BrnoMarsRover/myMachine-Fan/README.md

# myMachine-Fan
Repository for my Machine Walking FAN project, including software, PCBs, and documentation.

Link to documentation page (in Czech): [Documentation](https://brnomarsrover.github.io/myMachine-Fan/)
