BrnoMarsRover/myMachine-Fan/docs/hardware/hw.md

## Podvozek
Podvozek je třeba správně propojit s ostatním komponenty, viz schéma.
Konektory jednotlivých komponent jsou již připraveny a pro účely propojení s řídícím mikrokontrolerem jsou v podvozku dva univerzální plošné spoje.

Pohled zvrchu:
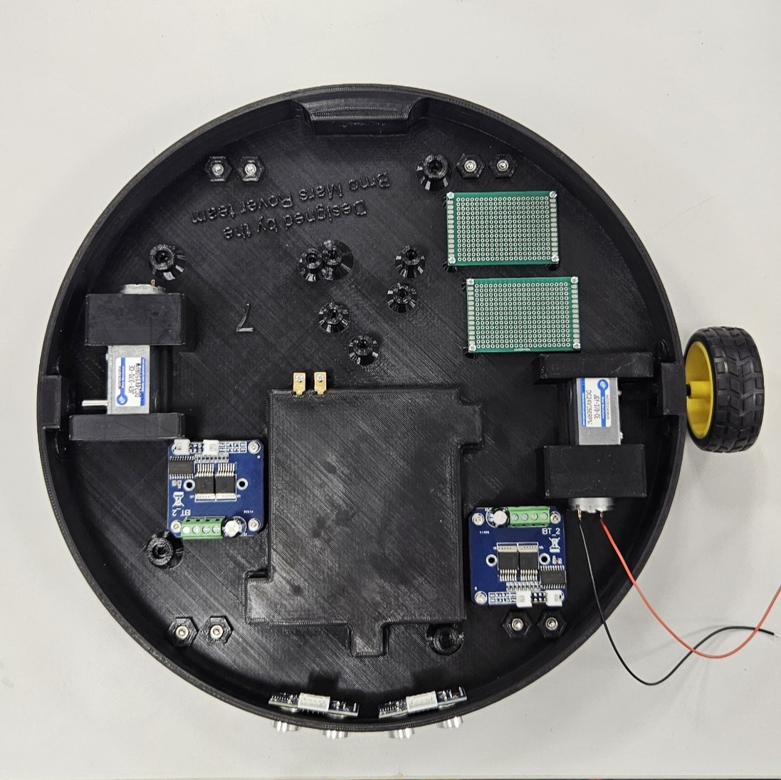
[picture p1: docs/images/hw/podvozek_top.jpg]
Podvozek_Top

Pohled zespodu:
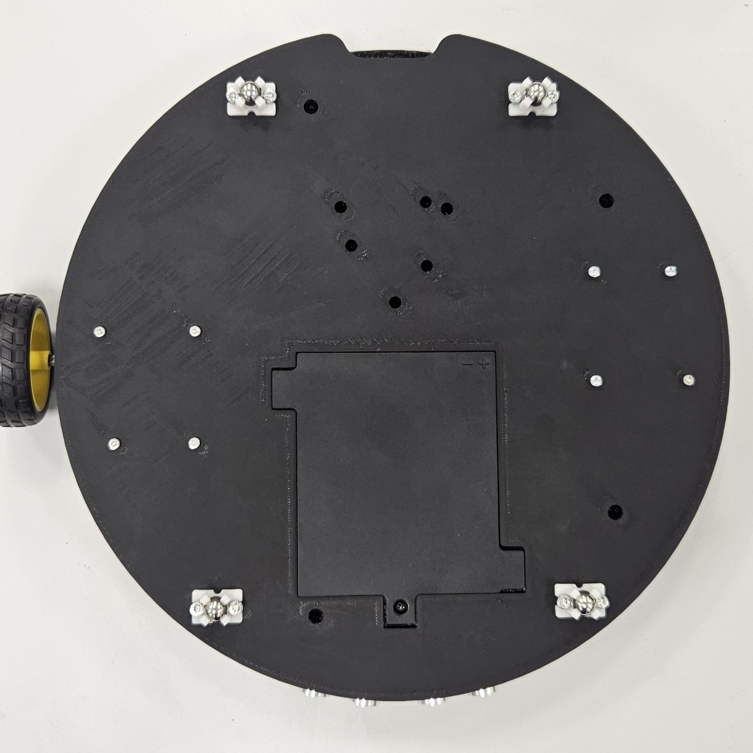
[picture p2: docs/images/hw/podvozek_bottom.jpg]
Podvozek_Bottom


Ultrazvukové senzory jsou pouze vtlačeny do děr, zbytek komponentů drží šroubky. Svorky na motory jsou připěvněny pomocí šroubků ze spodní strany.

## LED
LED pásek je třeba připevnit podél obvodu klece větráku (třeba pomocí utahovacích pásků)

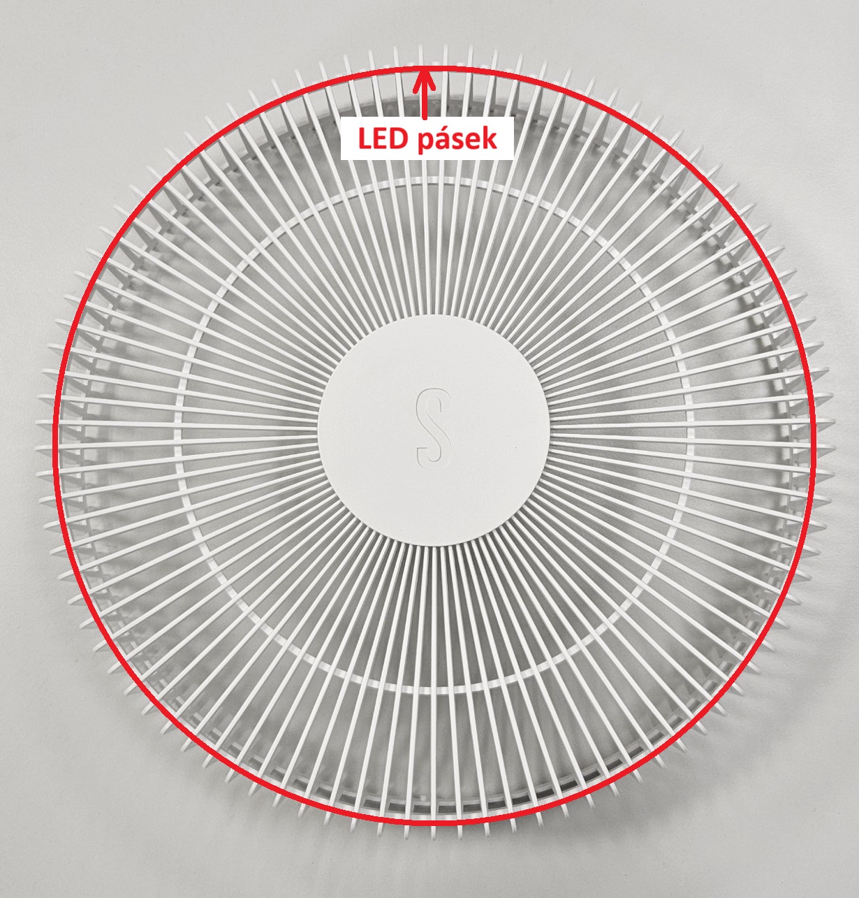
[picture p3: docs/images/hw/LED_pasek.jpg]
LED_pasek


Pro napájení LED pásku je třeba do hlavice umístit DC-DC měnič na konverzi z 24 V na 3.7 V.
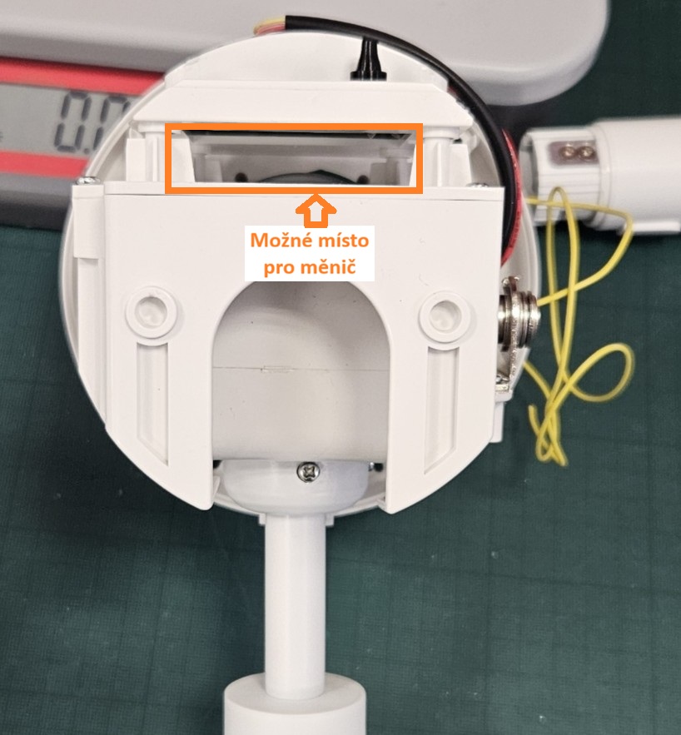
[picture p4: docs/images/hw/dcdc_misto.jpg]
DCDC_pozice


Pro komunikaci s mikrokontrolerem je připraven žlutý drát vyvedený do hlavice a podstavce (drát je připojen pomocí konektorů uvnitř trubky konstrukce, takže je stále rozebíratelná) 

Hlavice:
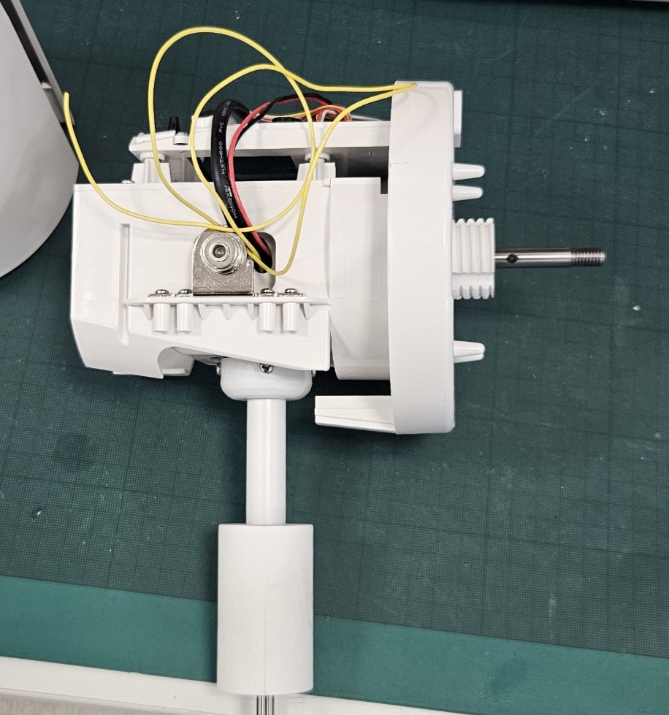
[picture p5: docs/images/hw/LED_konektor_hlavice.jpg]
LED_konektor_hlavice

Podstavec:
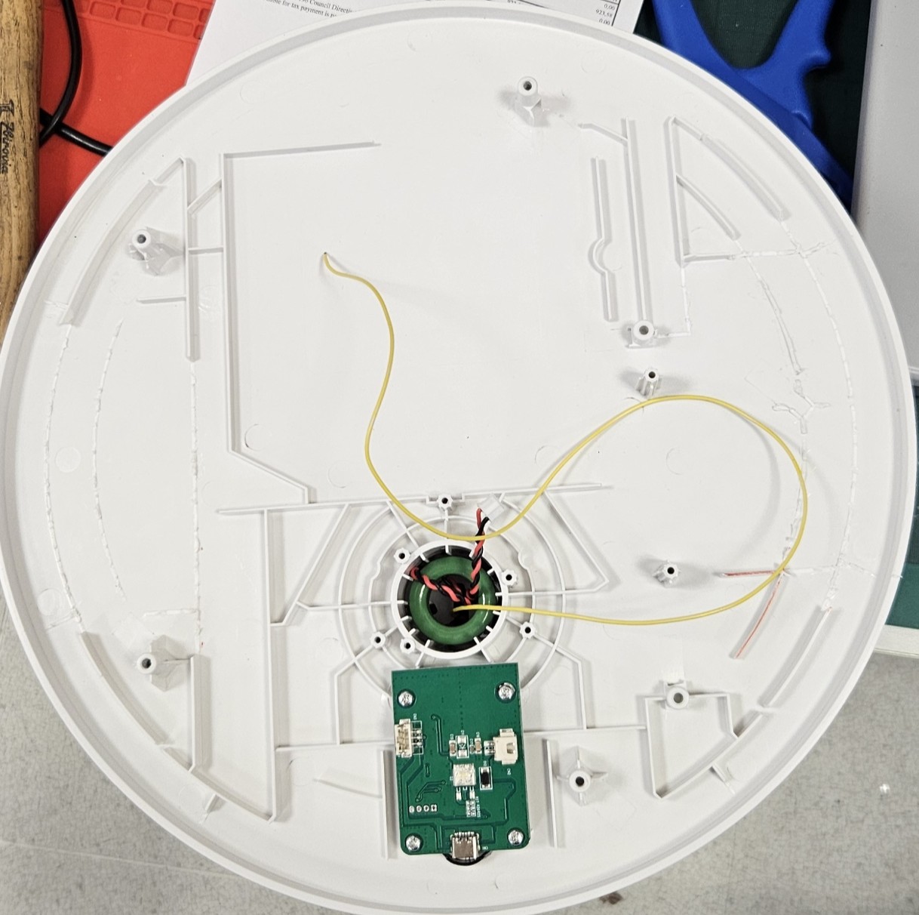
[picture p6: docs/images/hw/LED_konektor_baze.jpg]
LED_konektor_baze
