BrnoMarsRover/myMachine-Fan/docs/index.md

# My Machine Chodící Větrák

Vítej v dokumentaci projektu My Machine Chodící Vetrák! Zde budeme postupně vkládat všechny potřebné materiály k tomuto projektu.

Všechny soubory k projektu budou k dispozici v našem githubovém repozitáři [BrnoMarsRover/myMachine-Fan](https://github.com/BrnoMarsRover/myMachine-Fan.git). Pro jeho stažení stačí rozkliknout zelené tlačítko 'code' a zvolit 'stáhnout zip'.

## Autoři
- Stanislav Svědiroh
- Simona Petrovská
- Jan Zdebor
- Jan Drochýtek
