BrnoMarsRover/myMachine-Fan/site/hardware/pinout/index.html

- Hardware
- Schéma
- Edit on BrnoMarsRover/myMachine-Fan (https://github.com/BrnoMarsRover/myMachine-Fan/edit/main/docs/hardware/pinout.md)

## Schéma zapojení

Schéma zapojení

Previous Next

Built with MkDocs (https://www.mkdocs.org/) using a theme (https://github.com/readthedocs/sphinx_rtd_theme) provided by Read the Docs (https://readthedocs.org).

BrnoMarsRover/myMachine-Fan (https://github.com/BrnoMarsRover/myMachine-Fan) « Previous Next »
