BrnoMarsRover/myMachine-Fan/docs/big_picture.md

## Původní myšlenka

Děti ze základní školy Milotice si vysnily "chodící" větrák, který by vypadal jako mexičan (sombrero, poncho) a uměl by rozvážet jídlo.

Jejich nápad byl formulován tak, že by větrák sám aktivně sledoval člověka a jídlo za ním vozil zatímco by ho celou dobu ohříval.
Vzhledem k tomu, že takový nápad by byl technicky složitý, drahý a v náročných podmínkách základní školy nespolehlivý, rozhodli jsme se funkci sledování nahradit pouhým dálkovým ovládáním a vzhledem k bezpečnosti a hygieně místo ohřevu mexického jídla pouze připravit nádobku pro rozvoz např. balených bombónů.

Dětský nákres

## Naše vize
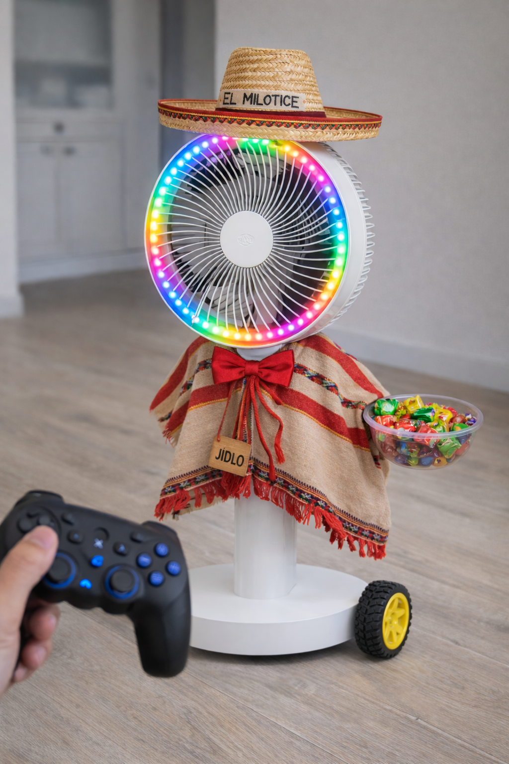
[picture p9: docs/images/vize.png]
Naše vize
