BrnoMarsRover/myMachine-Fan/3D/guma.stl

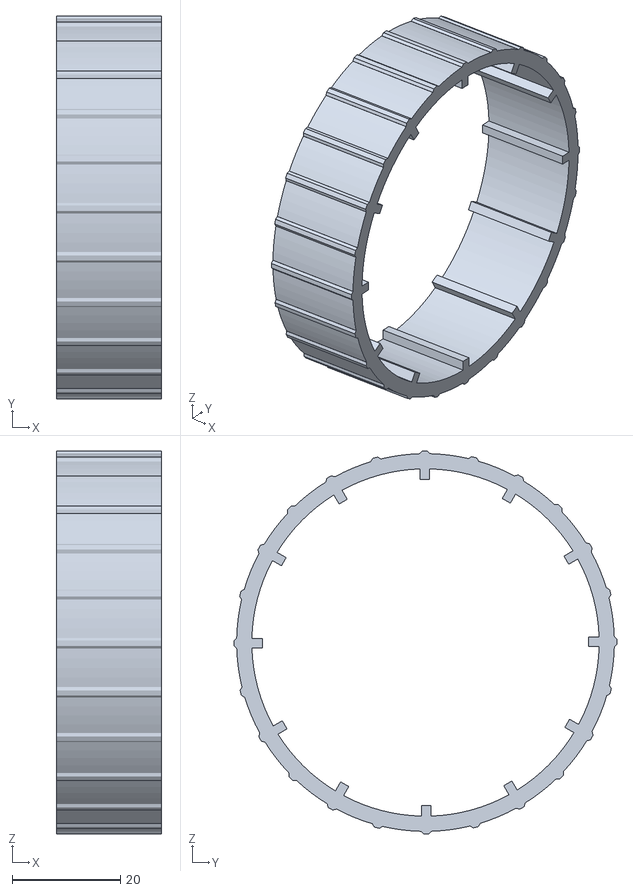
[picture p10: CAD file, 2026-02-19]
3D/guma.stl
19.4 x 70.8 x 70.8
