BrnoMarsRover/myMachine-Fan/3D/krytka_lozisko.step

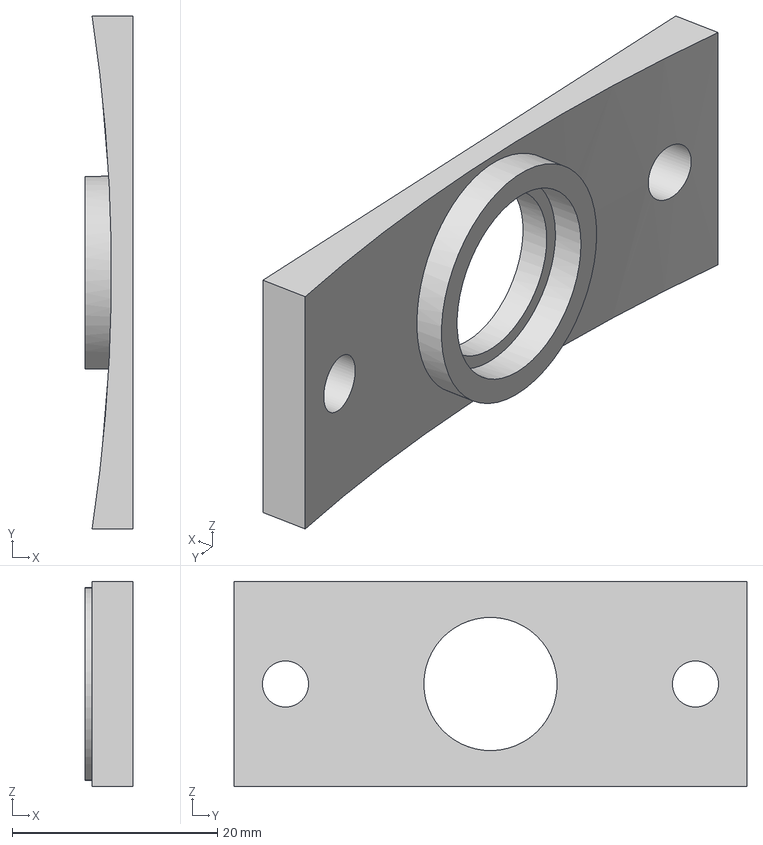
[picture p11: CAD file, 2026-02-19]
3D/krytka_lozisko.step
4.70 x 50.0 x 20.0 mm
