BrnoMarsRover/myMachine-Fan/3D/kolo.step

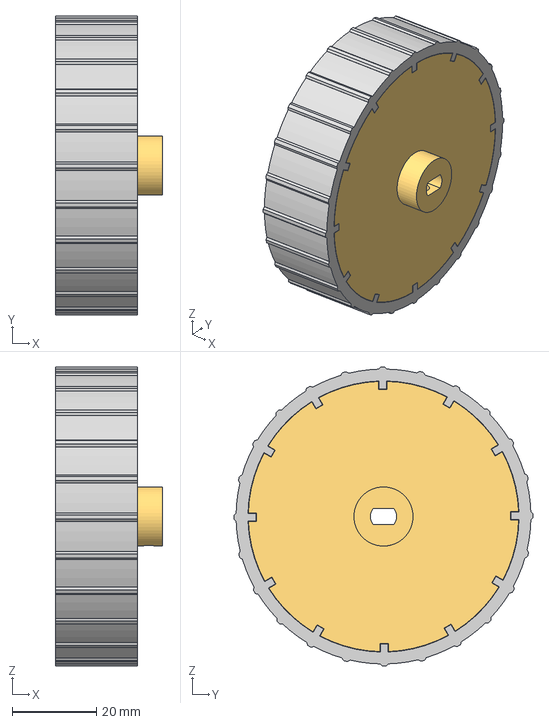
[picture p12: CAD file, 2026-02-19]
3D/kolo.step
25.4 x 70.8 x 70.8 mm
