BrnoMarsRover/myMachine-Fan/3D/uchyceni_klobouku.step

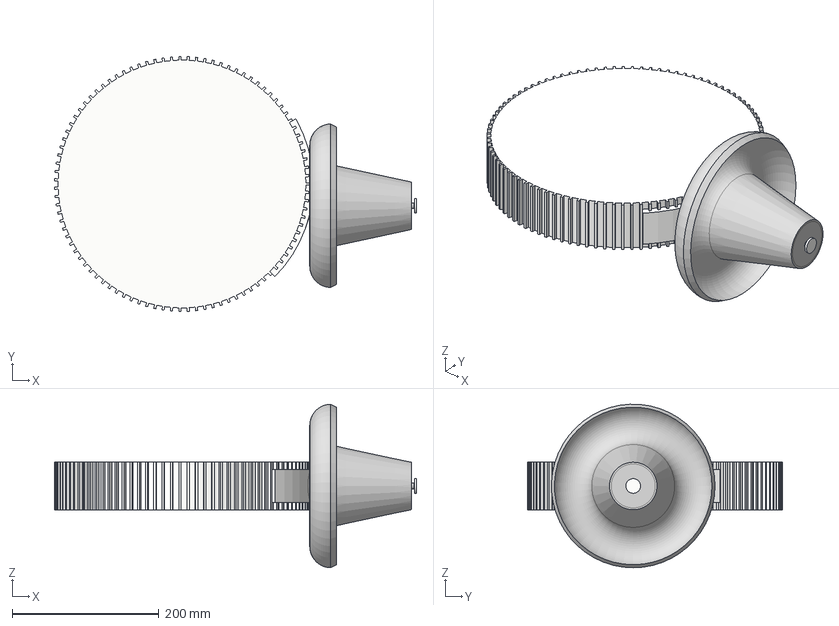
[picture p13: CAD file, 2026-02-19]
3D/uchyceni_klobouku.step
493.9 x 348.0 x 223.2 mm
