BrnoMarsRover/myMachine-Fan/3D/uchyceni_loziska_klobouku.stl

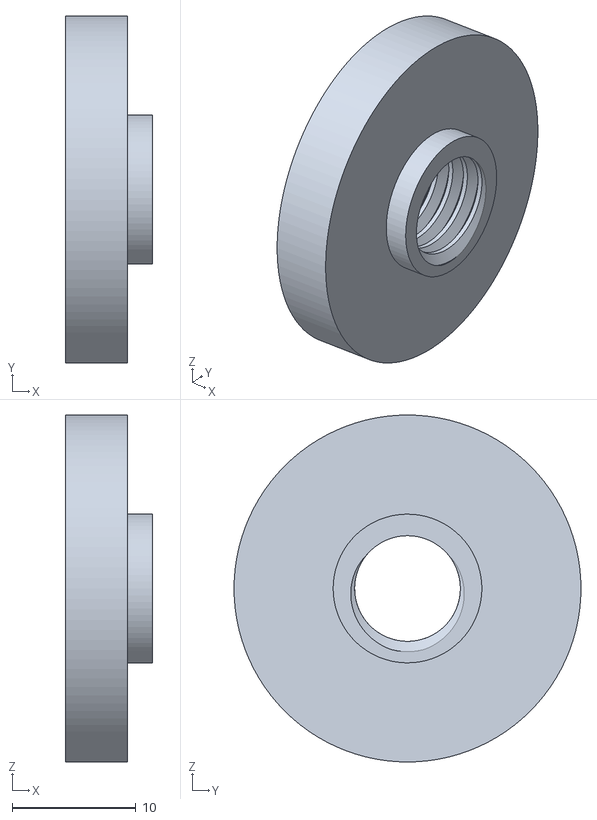
[picture p14: CAD file, 2026-02-19]
3D/uchyceni_loziska_klobouku.stl
7.00 x 28.0 x 28.0
