BrnoMarsRover/myMachine-Fan/3D/Krabička_Bombóny.step

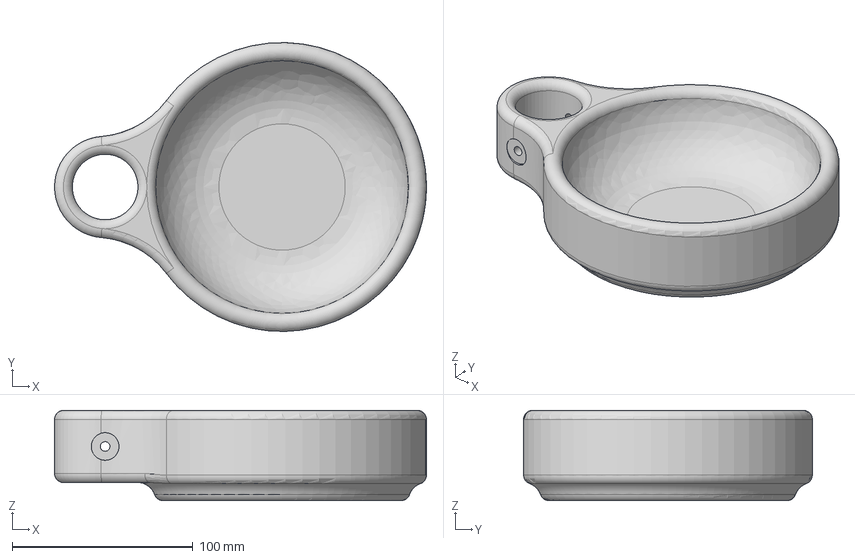
[picture p15: CAD file, 2026-02-19]
3D/Krabička_Bombóny.step
206.1 x 160.0 x 50.0 mm
