BrnoMarsRover/myMachine-Fan/3D/zarazka_klobouku.stl

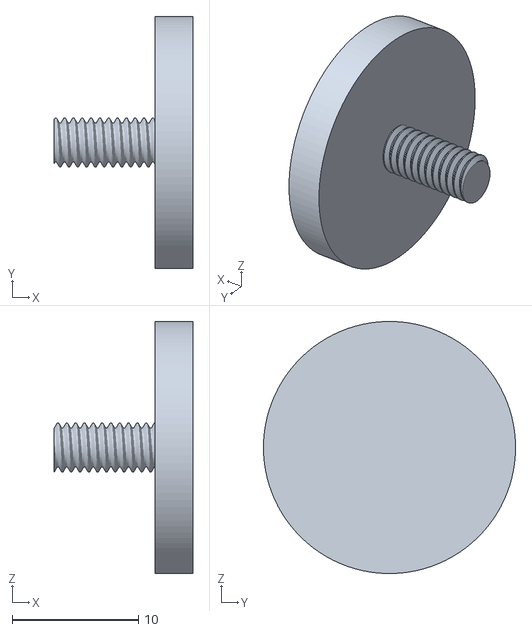
[picture p16: CAD file, 2026-02-19]
3D/zarazka_klobouku.stl
11.0 x 20.0 x 20.0
