BrnoMarsRover/myMachine-Fan/3D/motor_osa.step

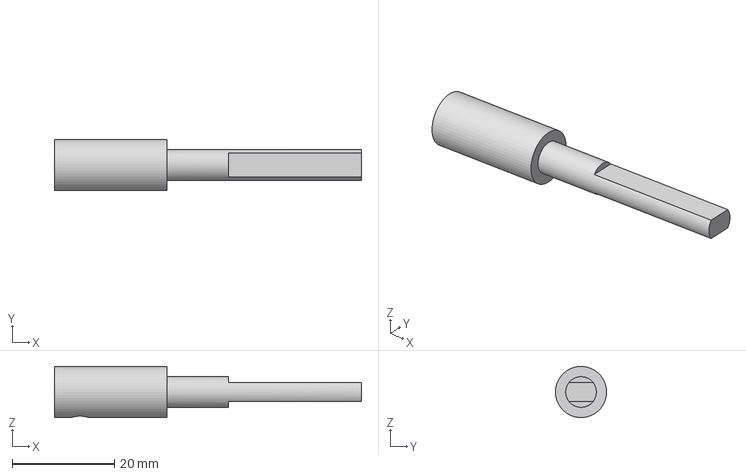
[picture p17: CAD file, 2026-02-19]
3D/motor_osa.step
60.0 x 9.99 x 10.00 mm
