BrnoMarsRover/myMachine-Fan/3D/Podvozek No History.step

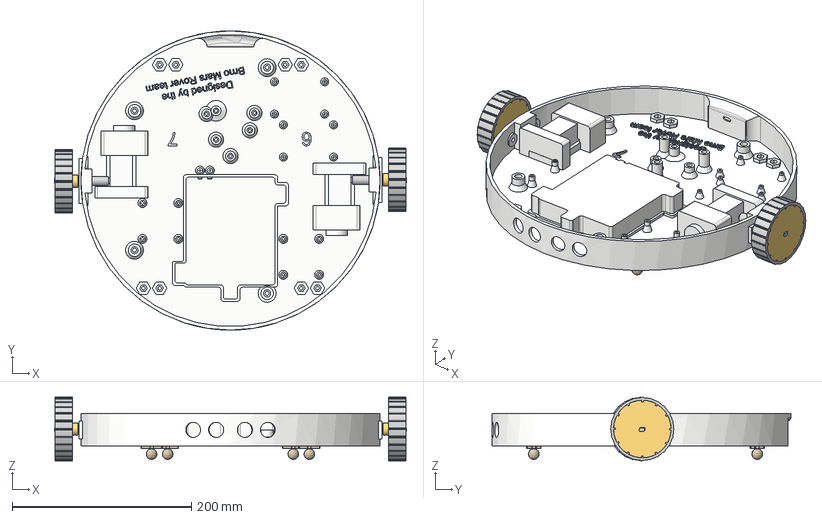
[picture p18: CAD file, 2026-02-19]
3D/Podvozek No History.step
392.3 x 333.5 x 70.8 mm
kulicka x 4
Kolo_Mlynsky x 2
