BrnoMarsRover/myMachine-Fan/(list of files, cad)

Other CAD files:
3D/Spojka.dwg
3D/krabicka_bonbony.stl
3D/kolo.stl
3D/krytka_lozisko.stl
3D/motor_osa.stl
3D/uchyceni_klobouku.stl
