BrnoMarsRover/myMachine-Fan/docs/construction/komponenty.md

## Komponenty finálního zařízení

| Položka |  Cena  | Odkaz | Již zakoupeno |
|:---|:---:|:---:|:---:|
| Bateriový větrák | 2679,- | [Alza](https://www.alza.cz/stadler-form-finn-mobile-levne-d12981822.htm) | Ano |
| 2x Motor 150RPM | 516,-  | [Laskakit](https://www.laskakit.cz/motor-jgy-370-24v-s-prevodovkou/) | Ano |
| 2x Ovladač motoru | 356,-  | [Laskakit](https://www.laskakit.cz/h-mustek-bts7960b-43a--motorovy-modul/) | Ano |
| ESP32 Vývojová deska | 198,-  | [Laskakit](https://www.laskakit.cz/iot-esp-32s-2-4ghz-dual-mode-wifi-bluetooth-rev-1--cp2102/) | Ano |
| 2x Napěťový měnič |  72,-  | [Laskakit](https://www.laskakit.cz/step-down-menic-s-lm2596/) | Ano | 
| 2x Snímač vzdálenosti | 112,-  | [Laskakit](https://www.laskakit.cz/ultrazvukovy-meric-vzdalenosti-hy-srf05--2-400-cm/) | Ano |
| 5x Opěrná kulička | 120,-  | [Laskakit](https://www.laskakit.cz/univerzalni-otocna-koule-n20-v-plastovem-pouzdre/) | Ano |
| 2x Kolečko |  50,-  | [Laskakit](https://www.laskakit.cz/kolo-s-prevodovanym-motorem/) | Ano |
| Led pásek 1m | 298,-  | [Laskakit](https://www.laskakit.cz/led-pasek-opleteny-neopixel-ws2812-50led-m-5v-ip67) | Ano |
| Bluetooth ovladač | 1399,- | [Alza](https://www.alza.cz/gaming/xbox-wireless-controller-robot-white-d6133564.htm) | Ano |
| Baterie AA | 139,-  | [Alza](https://www.alza.cz/alzapower-super-plus-alkaline-lr6-aa-10ks-v-eko-boxu-d6924320.htm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) | Ano |
| Bílý filament | 569,-  | [Prusa3D](https://www.prusa3d.com/cs/produkt/prusament-pla-pristine-white-1kg/) | Ano |
| Ložisko ke klobouku | 134,-  | [Mateza](https://www.mateza.cz/e-shop/lozisko-zkl-51101a) | Ano |
| 2x Ložisko pro kola |  34,-  | [Mateza](https://www.mateza.cz/e-shop/kulickove-lozisko-zkl-626-2z) | Ano |
| Prototypovací PCB 3x |  48,-  | [Laskakit](https://www.laskakit.cz/40x60mm-oboustranna-pcb-prototypova-deska/) | Ano |
| 20x Konektory JST-XH 4-pinové pravoúhlé |  12,-  | [Laskakit](https://www.laskakit.cz/jst-xh-2-54mm-konektor-do-dps--pravouhly/) | Ano |
| 10x Konektory JST-XH 2-pinové pravoúhlé |  6,- | [Laskakit](https://www.laskakit.cz/jst-xh-2-54mm-konektor-do-dps--pravouhly/) | Ano |
| 10x Konektory JST-XH 4-pinové |  6,- | [Laskakit](https://www.laskakit.cz/jst-xh-2-54mm-konektor-do-dps/) | Ano |
| Vodiče od každé barvy 1x | 350,-  | [Laskakit](https://www.laskakit.cz/propojovaci-vodice-20cm-100-kusu/?variantId=16604) | Ano |
| 50x Pin pro konektor |  50,-  | [Laskakit](https://www.laskakit.cz/pin-pro-konektor-jst-xh/) | Ano |
| 20x Tělo konektoru 4-pinové |  20,-  | [Laskakit](https://www.laskakit.cz/jst-xh-2-54mm-telo-konektoru/?variantId=5360) | Ano |
| 20x Tělo konektoru 2-pinové |  10,-  | [Laskakit](https://www.laskakit.cz/jst-xh-2-54mm-telo-konektoru/?variantId=5360) | Ano |
| Sada na výrobu konektorů |  96,-  | [Laskakit](https://www.laskakit.cz/laskakit-sada-jst-sm-konektoru-40ks/) | Ano |
| (náhradní) ESP32 Vývojová deska | 198,-  | [Laskakit](https://www.laskakit.cz/iot-esp-32s-2-4ghz-dual-mode-wifi-bluetooth-rev-1--cp2102/) | Ano |
| 20x konektor |  36,-  | [Kondik](https://www.kondik.cz/kontakt-43030-0001-pro-konektory-micro-fit/) | Ano |
| 10x konektor |  49,-  | [Kondik](https://www.kondik.cz/kontakt-43031-0001-pro-konektory-micro-fit/) | Ano |
| 10x konektor |  15,-  | [Kondik](https://www.kondik.cz/kontakt-mini-fit-5556-t3/) | Ano |
| 20x konektor |  30,-  | [Kondik](https://www.kondik.cz/kontakt-mini-fit-5558-t3/) | Ano |

- Střední škola vyrobí poncho a mexický klobouk (pokud je v jejich možnostech). Klobouk přibližně 110mm v průměru, 120mm
  na výšku. Na přesných rozměrech až tak nezáleží.

- -Spojovací materiál a drobný elektromateriál není v tabulce uveden, počítá se, že je na střední škole dostupný v rámci
  dílen.
