BrnoMarsRover/myMachine-Fan/site/construction/3d_tisk/index.html

- Komponenty
- 3D tištěné díly
- Edit on BrnoMarsRover/myMachine-Fan (https://github.com/BrnoMarsRover/myMachine-Fan/edit/main/docs/construction/3d_tisk.md)

# 3D tištěné díly

Několik dílů zařízení je vyrobeno 3D tiskem. Tato stránka popisuje seznam dílů, kde najít soubory a doporučené nastavení tisku.

Poznámka: Podvozek bude pro střední školu již vytištěn a dodán, protože vyžaduje velkoformátovou 3D tiskárnu. Ostatní menší díly (nádobka na bonbóny apod.) si lze vytisknout na běžné tiskárně.

## STL soubory

Všechny soubory pro tisk najdete ve složce stl/ (https://github.com/BrnoMarsRover/myMachine-Fan/tree/main/stl) v repozitáři.

## Seznam 3D tištěných dílů

Díl | Soubor | Počet kusů | Poznámka
Podvozek – spodní díl | | 1 | Obsahuje úchyty pro motory a kuličky. Dodán vytištěný.
Podvozek – horní díl | | 1 | Kryt elektroniky. Dodán vytištěný.
Nádobka na bonbóny | | 1 | Pro rozvoz bonbónů

## Doporučené nastavení tisku

Parametr | Hodnota
Materiál | PLA bílý (Prusament PLA Pristine White)
Tryska | 0.4 mm
Výška vrstvy | 0.2 mm
Výplň | 20 %
Perimetry | 3
Podpěry | Kde je potřeba (převisy > 45°)
Teplota trysky | 215 °C (dle doporučení výrobce filamentu)
Teplota podložky | 60 °C

## Příprava po tisku

1. Odstraňte podpěry – opatrně odlomte nebo odřízněte
2. Začistěte hrany – pilníkem nebo brusným papírem odstraňte otřepy
3. Zkontrolujte rozměry – zejména otvory pro ložiska a motory:
4. Ložisko ZKL 626-2Z (vnější průměr 19 mm) musí do otvoru pasovat těsně
5. Motor JGY-370 musí sedět v úchytu bez vůle
6. Zkušební sestavení – zkuste nasadit ložiska a motory nanečisto (bez pájení a kabelů)

## Tipy

- Pokud je otvor na ložisko příliš těsný, opatrně ho rozšiřte kulatým pilníkem
- Pokud je naopak příliš volný, lze použít kapku sekundového lepidla
- PLA je citlivé na teplo – nenechávejte díly na přímém slunci nebo v autě
- Při tisku větších dílů může pomoci adhesive (lepidlo na podložku) proti odlepování

Previous Next

Built with MkDocs (https://www.mkdocs.org/) using a theme (https://github.com/readthedocs/sphinx_rtd_theme) provided by Read the Docs (https://readthedocs.org).

BrnoMarsRover/myMachine-Fan (https://github.com/BrnoMarsRover/myMachine-Fan) « Previous Next »
