BrnoMarsRover/myMachine-Fan/docs/construction/rozborka.md

## Jak rozložit původní zařízení?

Zakoupený větrák je velice jednoduché rozložit. V celém procesu není třeba nic páčit, ani vyvíjet hrubou sílu. Všechny díly jsou k sobě sešroubované, v žádném místě zařízení nejsou využity plastové zacvakávací "jazýčky". 

Začněte tím, že si ze zařízení vezmete pouze základnu, otočíte ji vzhůru nohama a odstraníte kryt battery packu připevněný jedním šroubem.
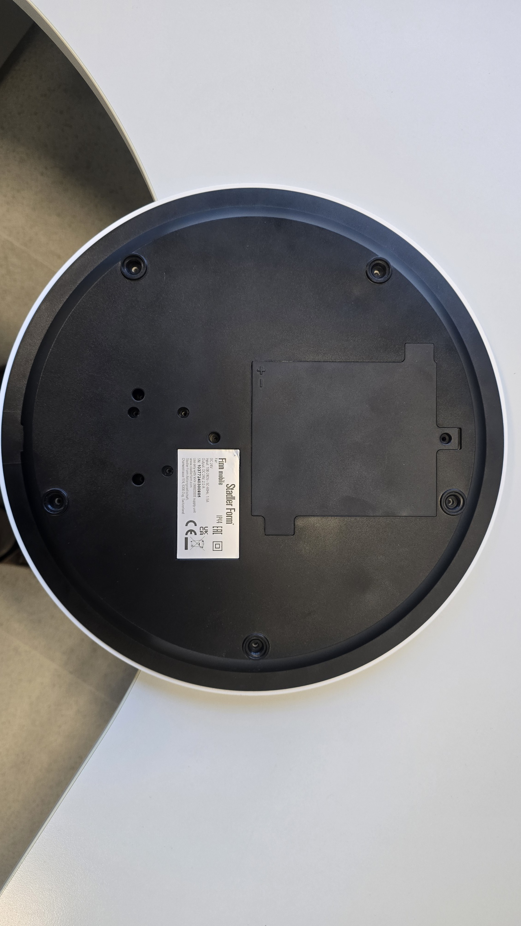
[picture p23: docs/images/rozborka/1.jpg]
Kryt baterie 1


Po otevření přihrádky baterie baterii odšroubujte a vyjměte ze zařízení. Dbejte zvýšenou opatrnost na "pogo piny", které doléhají na kontakty zařízení na levé straně obrázku. Pokud baterii neopatrně vyjmete nebo vložíte, je velice jednoduché tyto piny zalomit.
V případě, že se vám to i tak povede, přikládáme vám pár náhradních :)
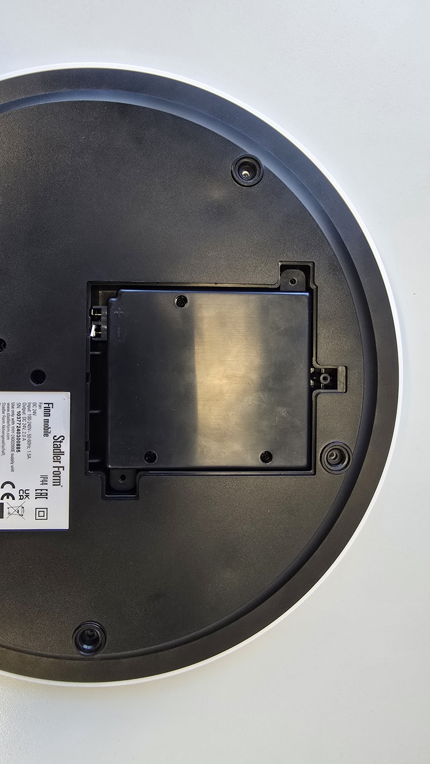
[picture p24: docs/images/rozborka/2.jpg]
Kryt baterie 2

Po vyjmutí baterie již můžeme přistoupit k odejmutí černého spodního krytu. Drží jej dohromady 11 šroubů, přičemž 5 z nich je schovaných pod gumovými nožičkami.
POZOR! Tento díl je přidělaný kabelem k desce plošných spojů, která je uchycená k bílému krytu na druhé straně. Odejměte ho tedy pomalu a kabel nejprve odpojte.
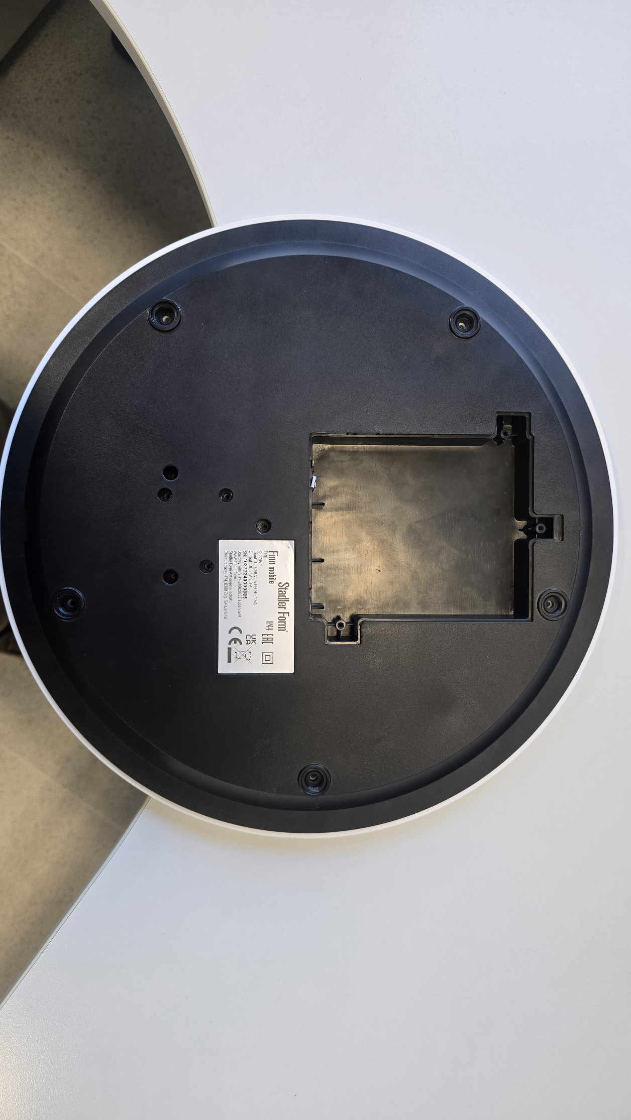
[picture p25: docs/images/rozborka/3.jpg]
Kryt baterie 3


Černý díl budeme v našem zařízení nahrazovat, až budeme mít náhradu z 3D tiskárny, bude třeba přenést bateriové kontakty s kabelem do nového dílu.
Druhý kabel z desky plošných spojů vede sloupkem směrem k samotným motorkům větráku. My budeme k těmto napájecím kabelům přidávat i datový kabel pro ovládání světelného LED pásku. Konektor vedoucí sloupkem má ještě dvě neosazené pozice, vytvoříme tedy dodatečný kabel, který protáhneme celou délkou sloupku.
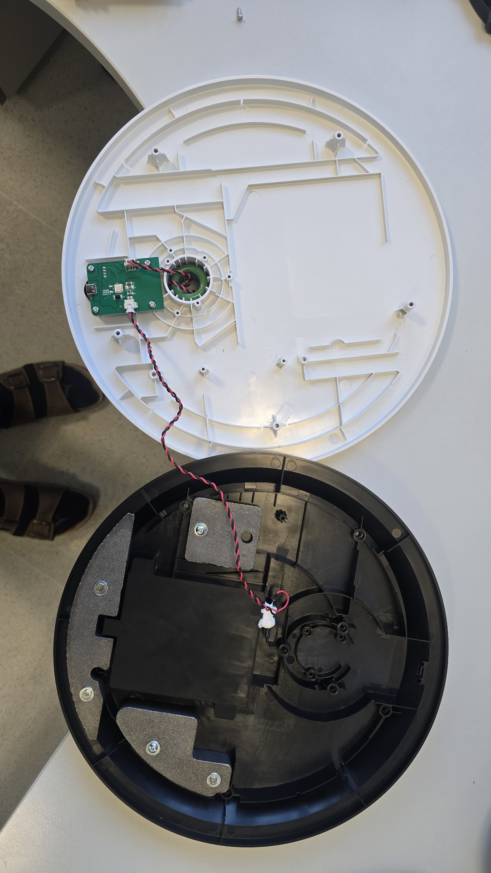
[picture p26: docs/images/rozborka/4.jpg]
Kryt baterie 4

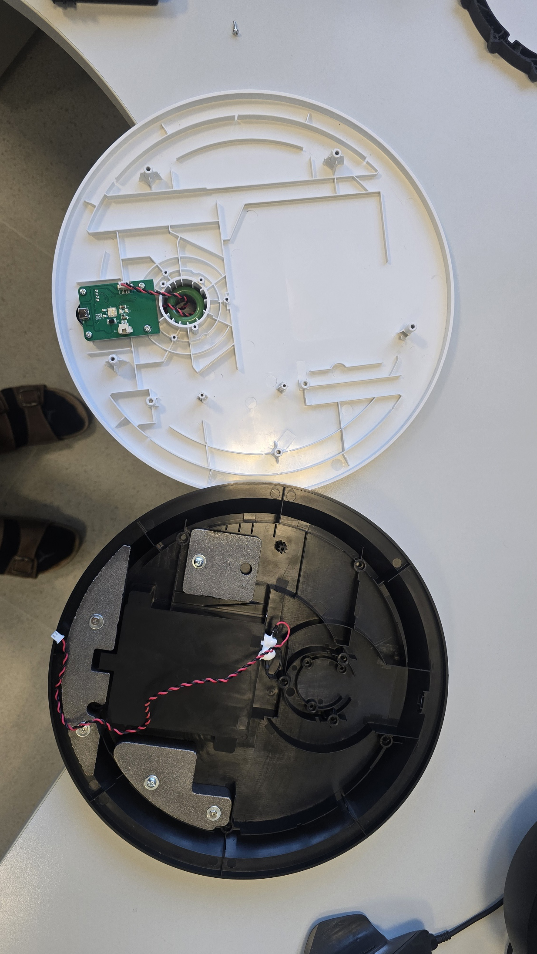
[picture p27: docs/images/rozborka/5.jpg]
Kryt baterie 5


Rozborka sloupku a všech konektérů v serii je podobná, ukážeme si příklad na sloupku samotném. Z jedné strany sloupku uvnitř vyjmeme aretační šroubek.
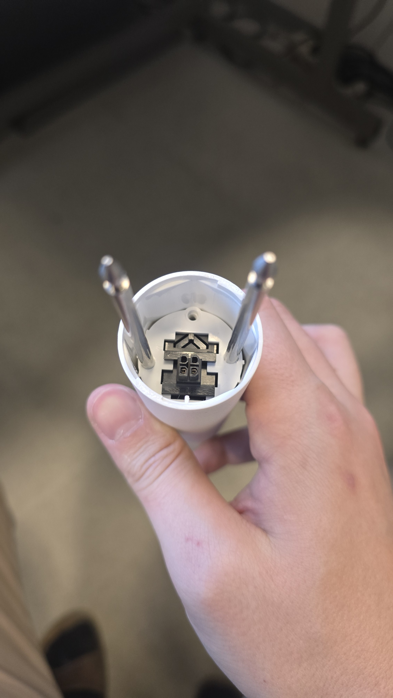
[picture p28: docs/images/rozborka/6.jpg]
Kryt baterie 6

Z druhé strany sloupku vyjmeme 4 aretační šroubky z bočních stran
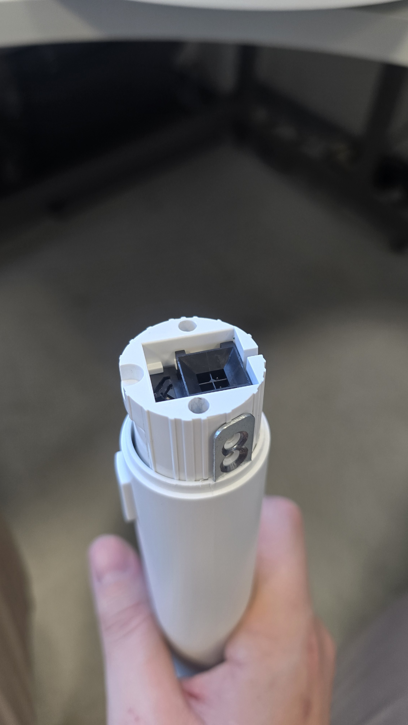
[picture p29: docs/images/rozborka/7.jpg]
Kryt baterie 7


Bez výrazné použité síly nyní můžeme konektory ze sloupku vyjmout. Na jedné straně k tomu bude třeba protlačit boční tlačítko dovnitř (taktéž i u spodního konektoru pod sloupkem na fotografii níže).
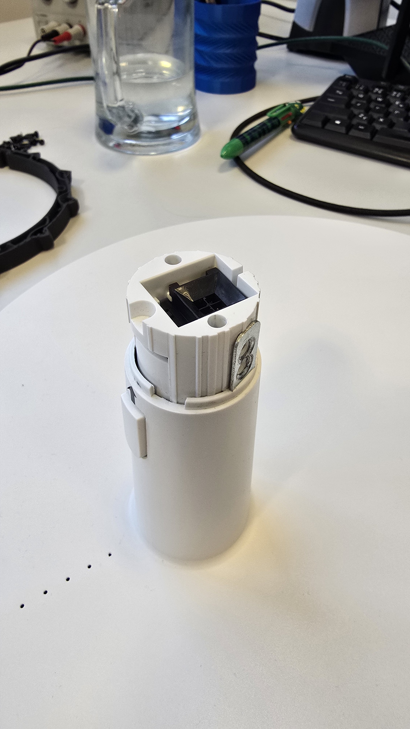
[picture p30: docs/images/rozborka/8.jpg]
Kryt baterie 8


Samotný mechanismus s tlačítkem je složen z několika dílů. Dávejte při otevření pozor, uvnitř je umístěná pružina. 
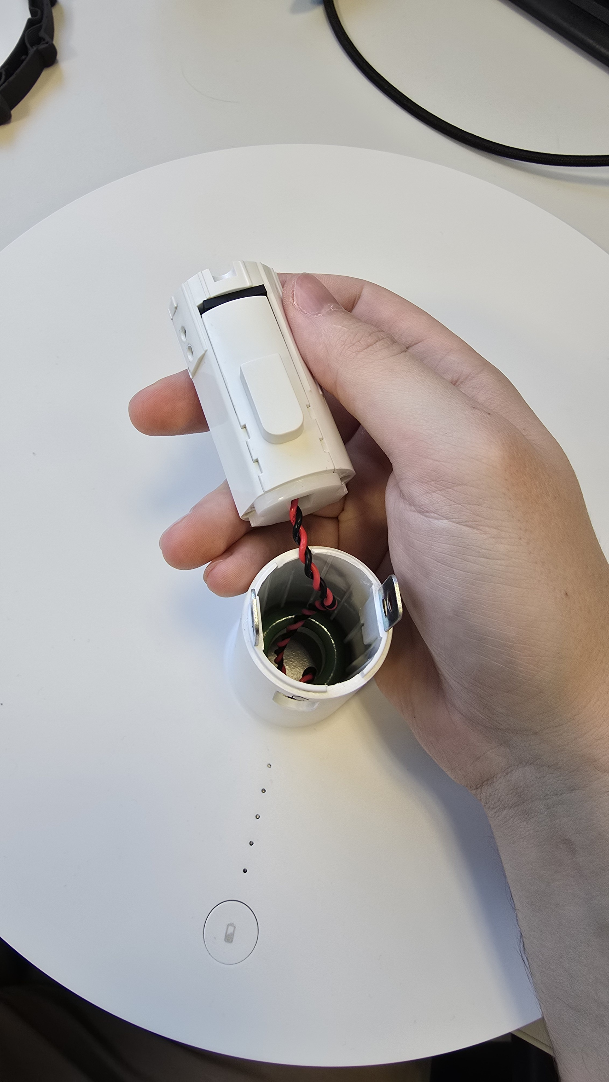
[picture p31: docs/images/rozborka/9.jpg]
Kryt baterie 9

Na poprvé to bude možná trochu zápas, zkuste si hned po rozložení mechanismus opět složit, aby jste si zapamatovali, jak do sebe zapadá.
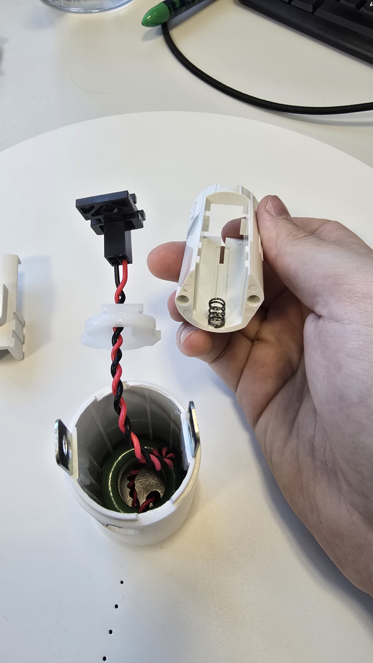
[picture p32: docs/images/rozborka/10.jpg]
Kryt baterie 10


Pro správné protažení signálového kabelu pro LED pásek a připojení napájení k LED pásku budeme potřebovat rozebrat i samotnou konstrukci ventilátoru. Odšroubujeme tak tedy 4 šrouby po vnějším okraji. Tři šrouby uprostřed drží pouze DC motor a není třeba je vyšroubovávat.
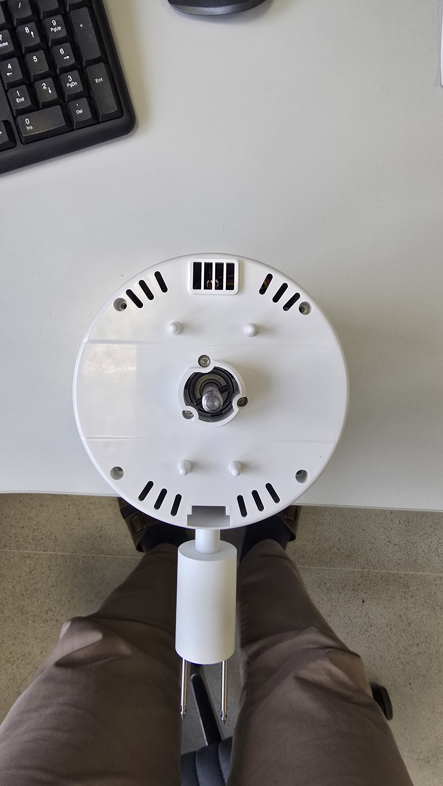
[picture p33: docs/images/rozborka/11.jpg]
Kryt baterie 11


Zbytek sloupku ohneme následujícím způsobem a celý válcový plášť stáhneme směrem doleva. Není potřeba používat žádnou sílu, ta byla potřeba pouze na poprvé, tlačítka už jsem za vás ulomil :).
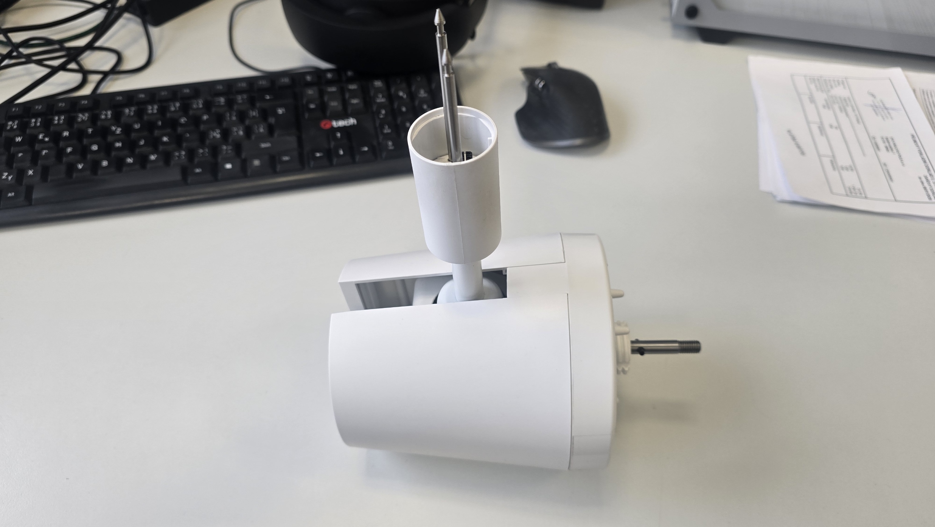
[picture p34: docs/images/rozborka/12.jpg]
Kryt baterie 12


Uvnitř nás čekají 3 konektory, přičemž ten 3-pinový je napájecí. Pokud chceme rozebrat konektor vedoucí od sloupku, musíme ho odpojit a prostřčit směrem zpět
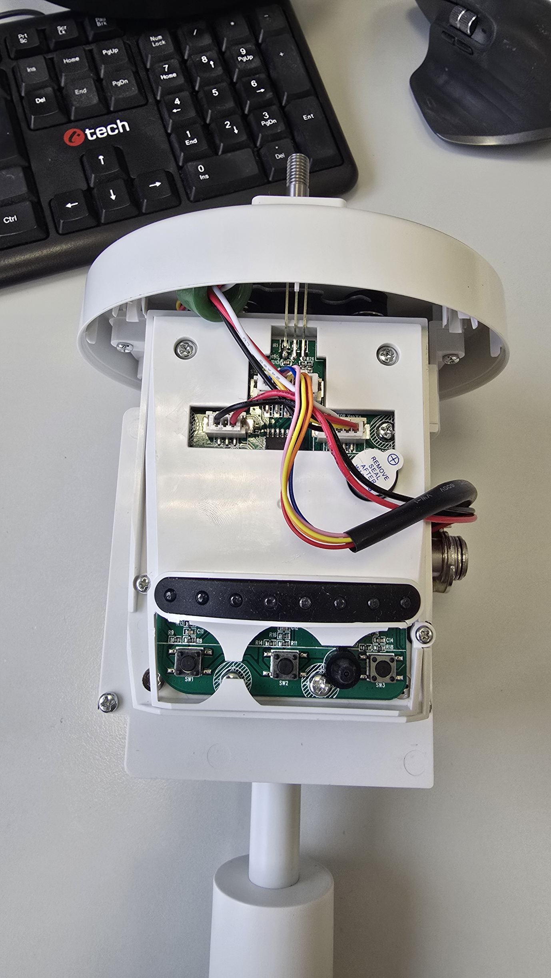
[picture p35: docs/images/rozborka/13.jpg]
Kryt baterie 13


Kabel lze skulinou prostrčit zpět, což nám umožní rozebrat konektor sloupku obdobným způsobem jako předtím.
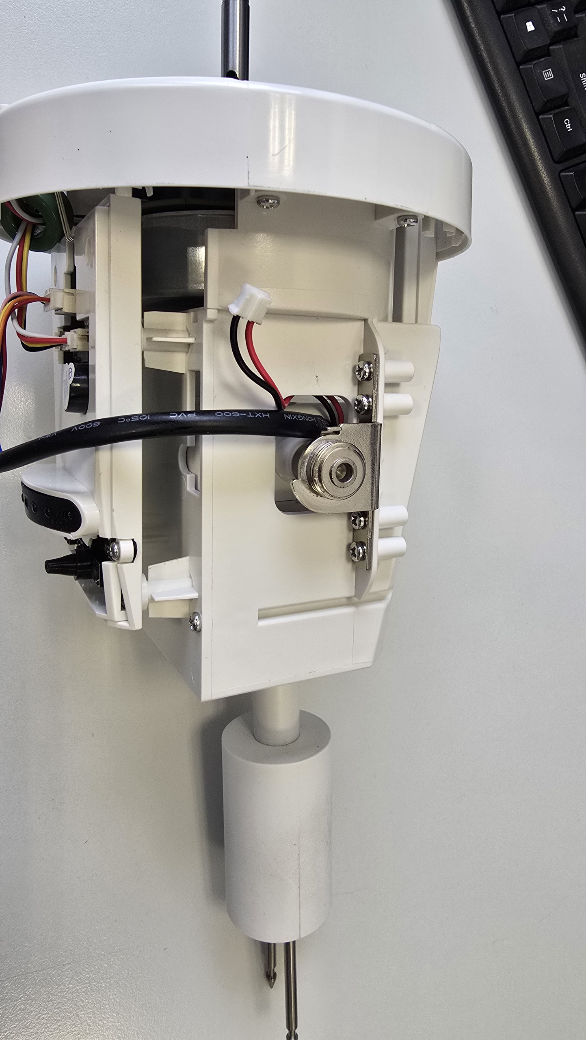
[picture p36: docs/images/rozborka/14.jpg]
Kryt baterie 14
