BrnoMarsRover/myMachine-Fan/3D/tyc_vetrak.pdf

# B M¹⁰

12

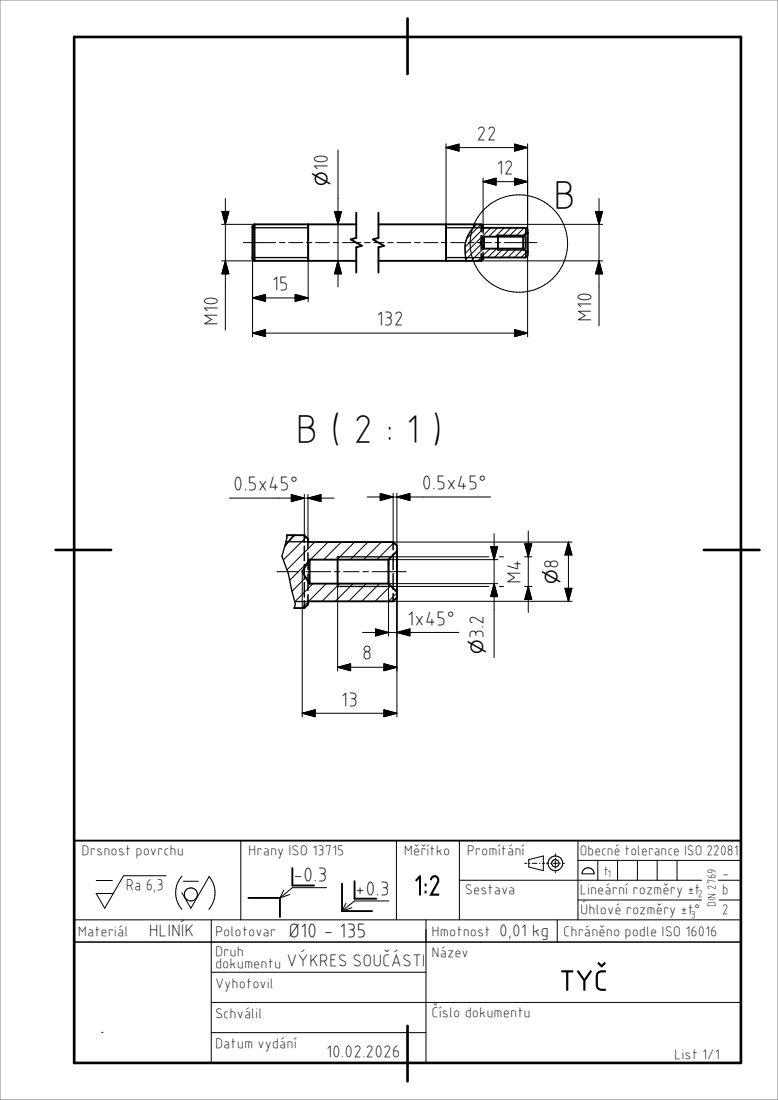
[picture p37: page 1]
Vyhotovil; Hrany ISO 13715; Sestava; Drsnost povrchu; Promítání; Měřítko; Hmotnost; DIN ²⁷⁶⁹ 2

Obecné tolerance ISO 22081
Lineární rozměry ±t
Úhlové rozměry ±t°

HLINÍK Materiál | Ø10 - 135 Polotovar | 0,01 kg | Chráněno podle ISO 16016

Druh VÝKRES SOUČÁSTI dokumentu | Název TYČ

Schválil | Číslo dokumentu List 1/1
Datum vydání 10.02.2026
