BrnoMarsRover/myMachine-Fan/site/images/hw/mymachine.drawio.pdf

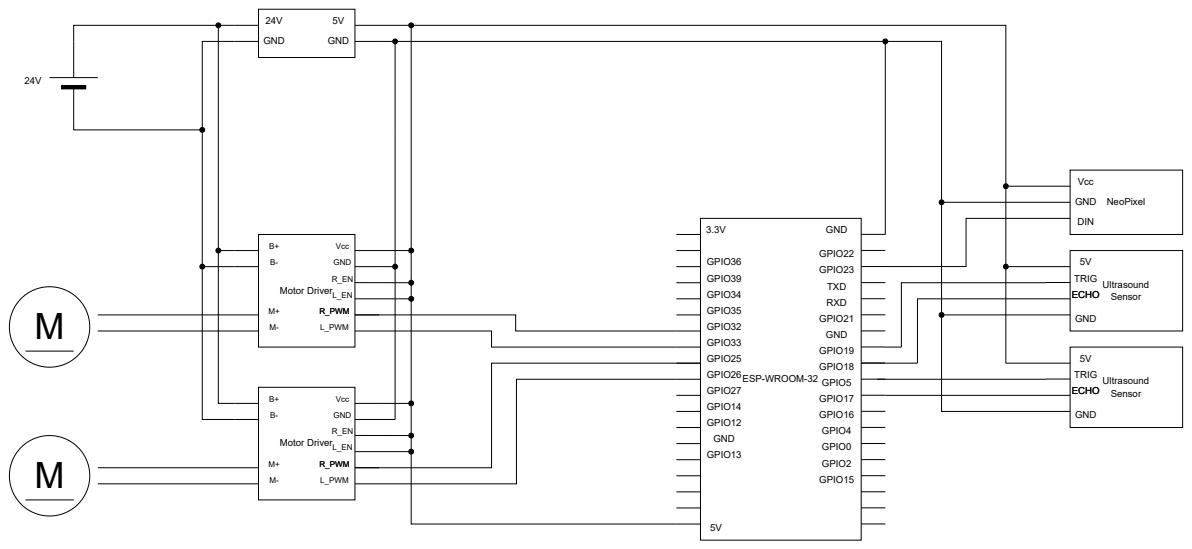
[picture p38: page 1]
ESP-WROOM-32; Motor Driver; Vcc; GND; R_PWM; L_PWM; GPIO36 GPIO39 GPIO34 GPIO35 GPIO32 GPIO33 GPIO25 GPIO26; Ultrasound Sensor; 5V TRIG ECHO; GPIO22 GPIO23; GPIO21; TXD RXD; GND GPIO19 GPIO18 GPIO5 GPIO17 GPIO16 GPIO4 GPIO0 GPIO2 GPIO15; GPIO27 GPIO14 GPIO12 GND GPIO13; NeoPixel; DIN
