BrnoMarsRover/myMachine-Fan/3D/klobouk_vykres.pdf

A

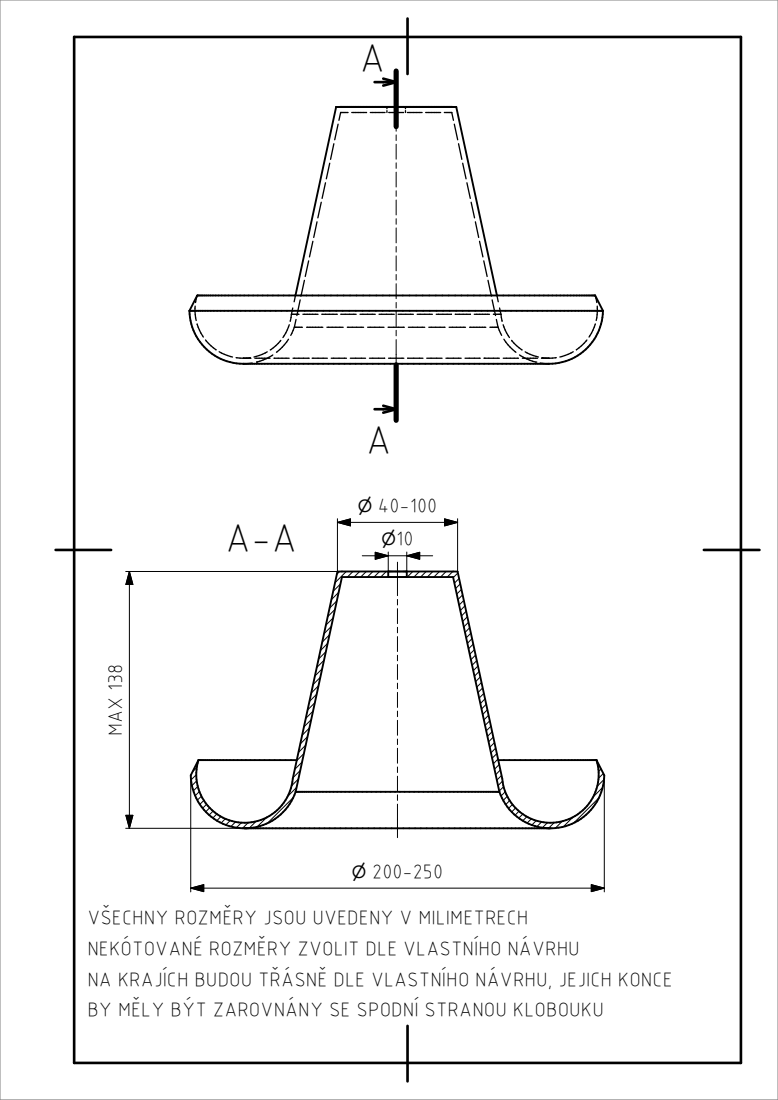
[picture p39: page 1]
A MAX ¹³⁸

VŠECHNY ROZMĚRY JSOU UVEDENY V MILIMETRECH
NEKÓTOVANÉ ROZMĚRY ZVOLIT DLE VLASTNÍHO NÁVRHU
NA KRAJÍCH BUDOU TŘÁSNĚ DLE VLASTNÍHO NÁVRHU, JEJICH KONCE
BY MĚLY BÝT ZAROVNÁNY SE SPODNÍ STRANOU KLOBOUKU
