BrnoMarsRover/myMachine-Fan/3D/Spojka.pdf

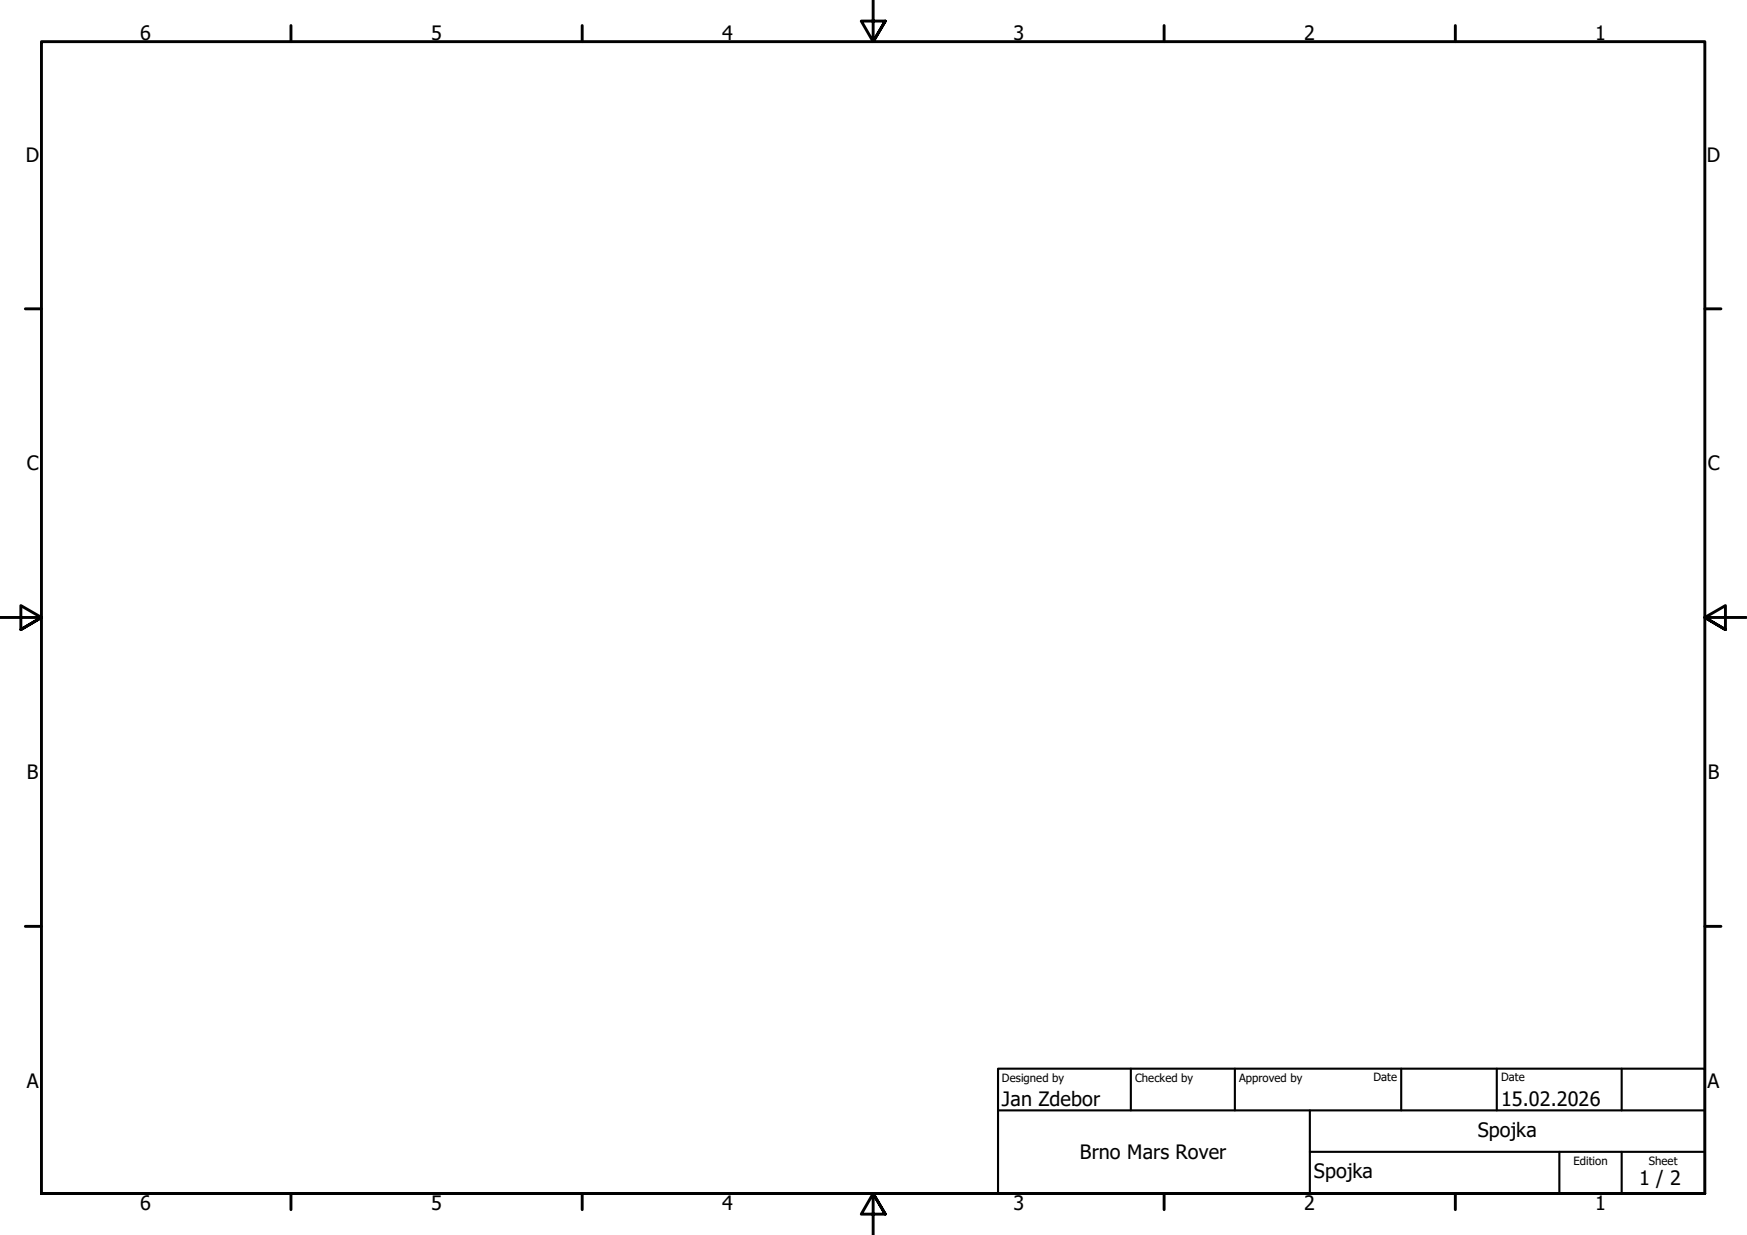
[picture p40: page 1]

Designed by Jan Zdebor | Checked by | Approved by Date | Date 15.02.2026

Brno Mars Rover | Spojka

Spojka | Edition | Sheet 1 / 2

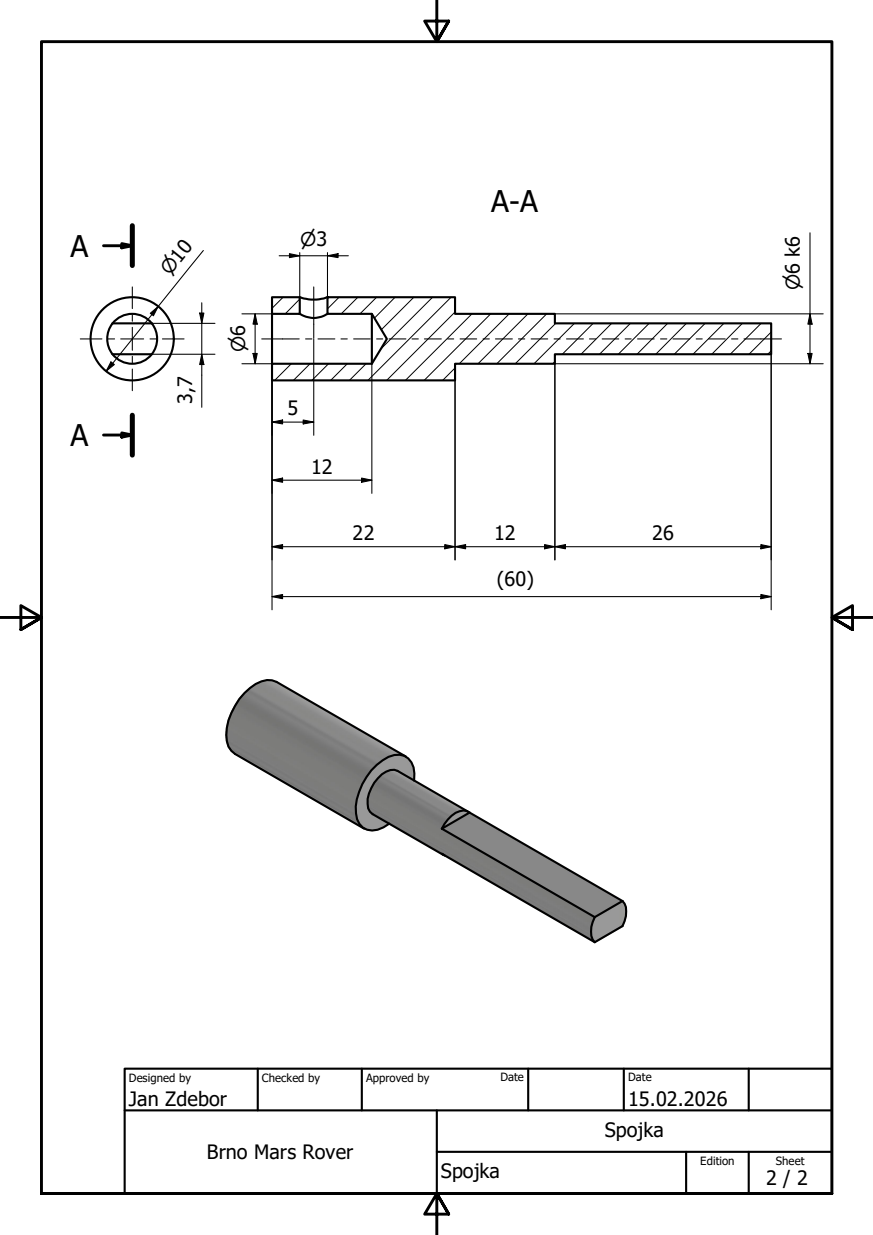
[picture p41: page 2]

Designed by Jan Zdebor | Checked by | Approved by Date | Date 15.02.2026

Brno Mars Rover | Spojka

Spojka | Edition | Sheet 2 / 2
