BrnoMarsRover/myMachine-Fan/(commit log)

2026-01-16 Add the LED strip
2026-01-21 Update bom
2026-02-12 Úprava schema
    Změněno zapojení motor driverů
    Přidán NeoPixel
2026-02-12 Úprava example kódu u motorů
2026-02-12 Přidána ultrasonic knihovna a odkazy
2026-02-13 Přidán 3.7V DCDC měnič do schéma
2026-02-19 add 3D files and missing images
    [Krabička_Bombóny.step, Podvozek No History.step, Spojka.dwg, guma.stl, guma_final.stl, kolo.step, kolo.stl, krabicka_bonbony.stl]
2026-03-14 Doplnění 3D dílů, obrázků a výkresů do dokumentace
    - 3d_tisk.md: oprava odkazu na složku 3D/, kompletní seznam dílů s obrázky a odkazy na výkresy
    - kostym.md: přidán obrázek uchycení klobouku a nádobky na bonbóny, odkaz na výkres klobouku
    - sestaveni.md: přidán odkaz na výkres spojky, obrázek adaptéru osy motoru a nádobky na bonbóny
